barnecle/EmbeddedSystems/lab9/screenShots/Screen Shot 2022-04-12 at 2.54.14 AM.png

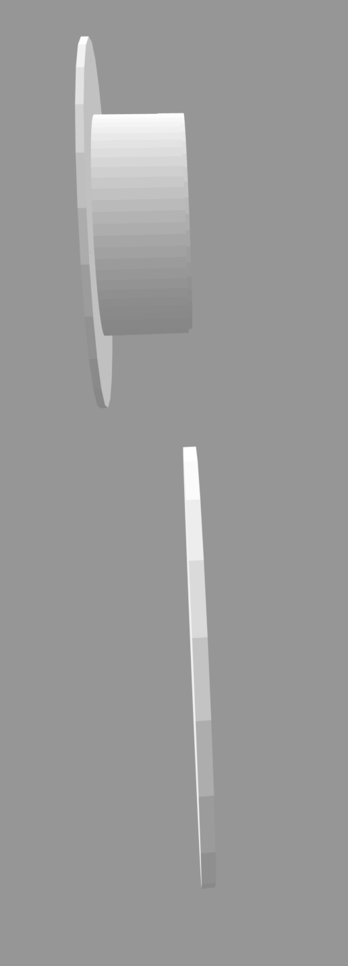
lab9/screenShots/Screen Shot 2022-04-12 at 2.54.14 AM.png
