barnecle/EmbeddedSystems/BOM.xlsx

Reference Designators | Component Manufacturer's Part number | Component Description | Distributor | Unit Cost | # of Units | Extended Cost | Link to component
U1 | STM32L432KCU6 | STM32L432KCUx | Digikey | 7.53 | 1 | 7.53 | https://www.digikey.com/en/products/detail/stmicroelectronics/STM32L432KCU6/6132749
C6. C4 | C0603C104K3RAC7013 | 0.1uF | Digikey | 0.14 | 2 | 0.28 | https://www.digikey.com/en/products/detail/kemet/C0603C104K3RAC7013/8572407
C2, C1 | 298D105X0016M2T | 1uF | Digikey | 1.09 | 2 | 2.18 | https://www.digikey.com/en/products/detail/vishay-sprague/298D105X0016M2T/1559509
TP1 |  | TestPoint |  |  |  | 0
U3 | TG-3541CE 32.7680KXB3 | 32.768 kHz TCXO CMOS Oscillator 1.5V ~ 5.5V Enable/Disable 10-SMD, No Lead | Digikey | 3.6 | 1 | 3.6 | https://www.digikey.com/en/products/detail/epson/TG-3541CE-32-7680KXB3/10239841
TP2 |  | TestPoint |  |  |  | 0
J1 | B3B-XH-A(LF)(SN) | CONN HEADER VERT 3POS 2.5MM | Digikey | 0.19 | 1 | 0.19 | https://www.digikey.com/en/products/detail/jst-sales-america-inc/B3B-XH-A-LF-SN/1651046
JP2 |  | Jumper_3_Open |  |  |  | 0
BT1 | 1060TR | Battery_Cell | Digikey | 1.54 | 1 | 1.54 | https://www.digikey.com/en/products/detail/keystone-electronics/1060TR/303557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
IC1 | TSL237S-LF | Optical Sensor Ambient 635nm Frequency Radial - 3 Leads | Digikey | 1.865 | 10000 | 18650
TP6 |  | TestPoint |  |  |  | 0
J3 | B4B-XH-A(LF)(SN) | CONN HEADER VERT 4POS 2.5MM | Digikey | 0.21 | 1 | 0.21
R3, R4 | ERJ-PA3F2000V | 200 R | Digikey | 0.16 | 2 | 0.32 | https://www.digikey.com/en/products/detail/panasonic-electronic-components/ERJ-PA3F2000V/5035883
U2 | FTSH-107-01-L-DV-K | CONN HEADER SMD 14POS 1.27MM | Digikey | 5.72 | 1 | 5.72 | https://www.digikey.com/en/products/detail/samtec-inc/FTSH-107-01-L-DV-K/6678186
