barnecle/EmbeddedSystems/Light_Sensor_schematic/OSH_PARK_ORDER.png

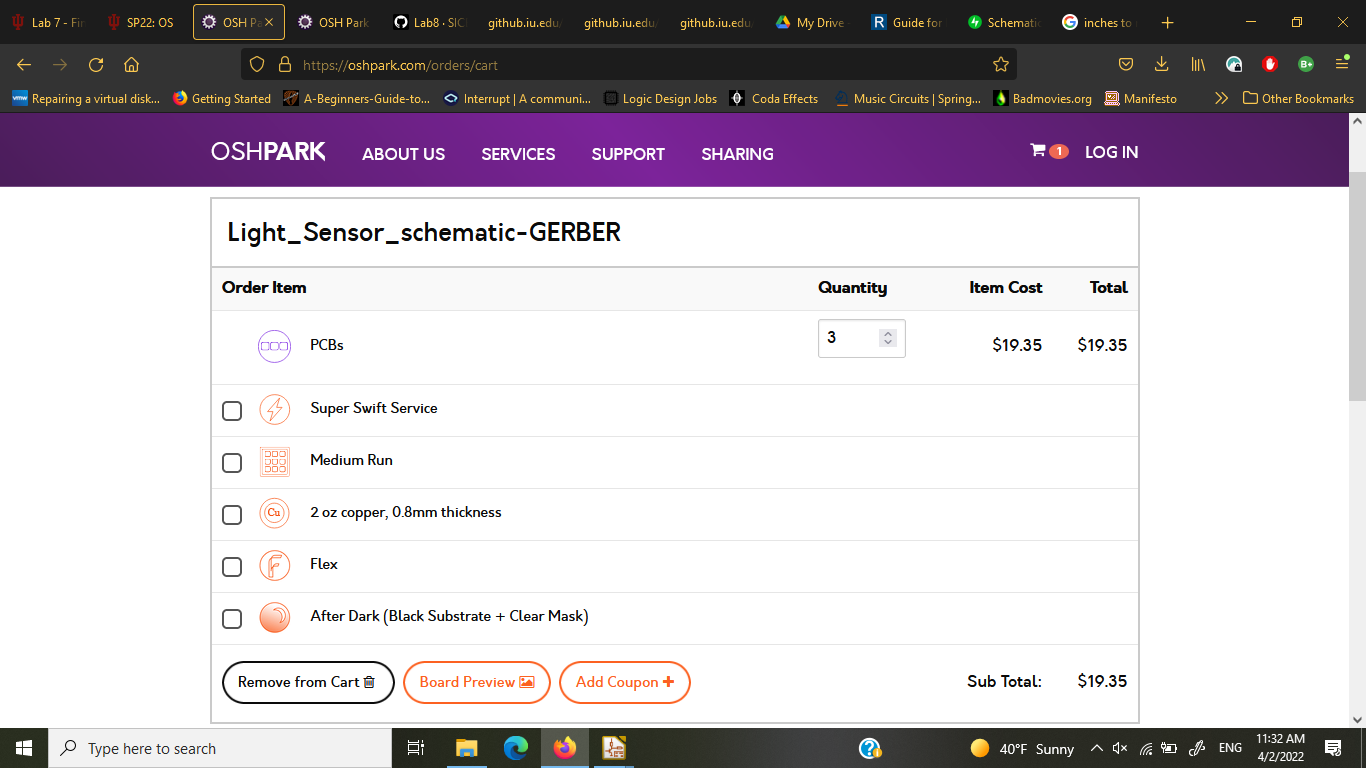
Light_Sensor_schematic/OSH_PARK_ORDER.png
