barnecle/EmbeddedSystems/kicad/parts/3D_Models/03__3DMODEL__TG-3541CE_REV0_ASM_sp.step

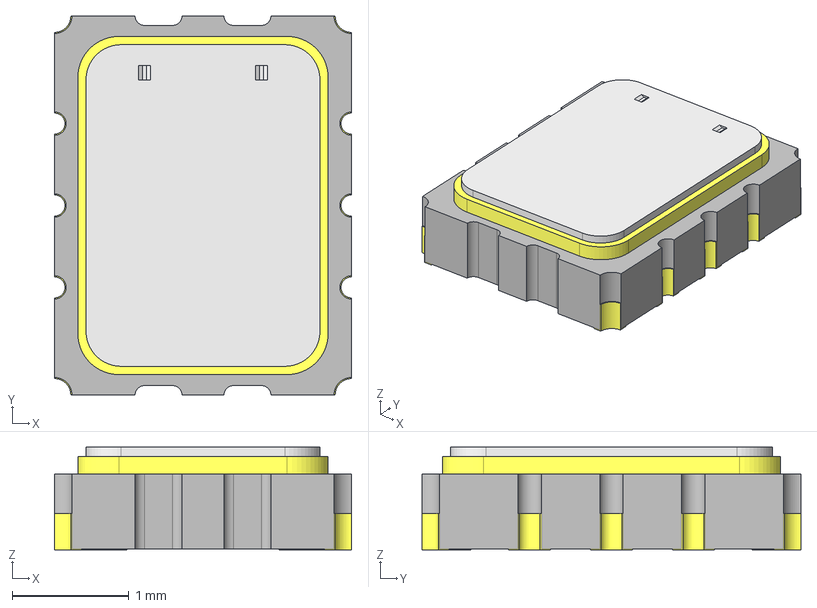
[picture p10: CAD file, 2022-03-24]
kicad/parts/3D_Models/03__3DMODEL__TG-3541CE_REV0_ASM_sp.step
2.54 x 3.24 x 0.88 mm
