barnecle/EmbeddedSystems/kicad/parts/3D_Models/Fusion_sp.step

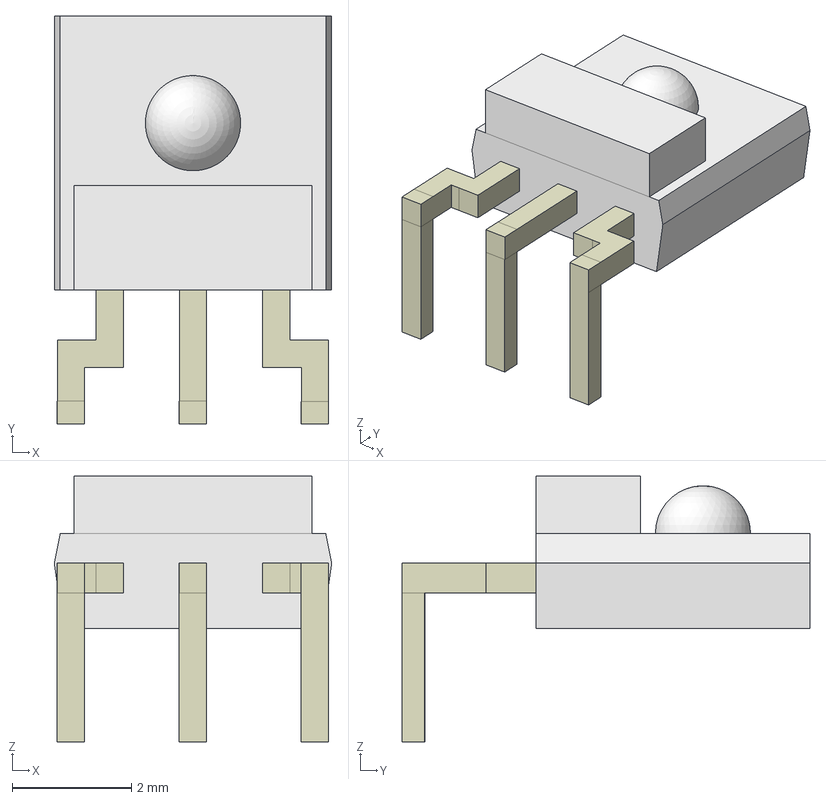
[picture p11: CAD file, 2022-03-24]
kicad/parts/3D_Models/Fusion_sp.step
4.66 x 6.85 x 4.46 mm
