barnecle/EmbeddedSystems/lab9/bottom_part.stl

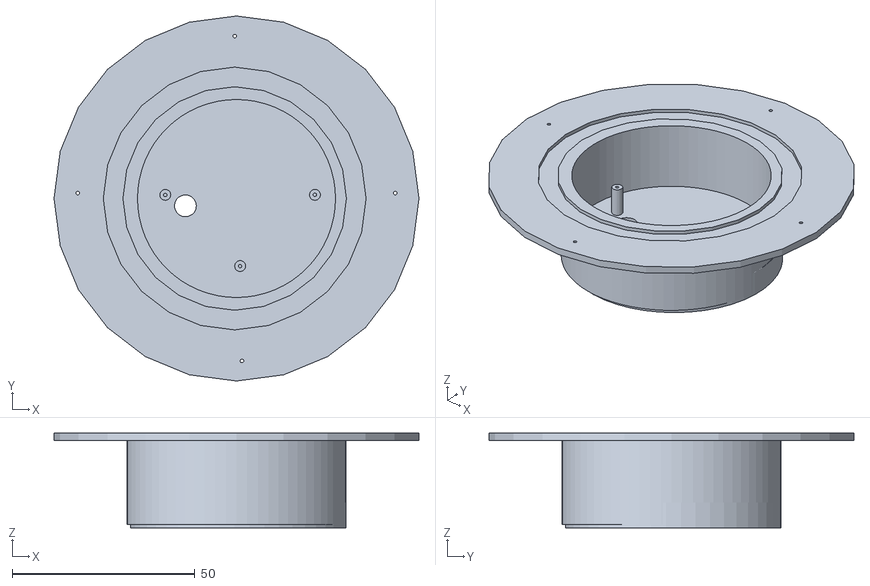
[picture p12: CAD file, 2022-04-20]
lab9/bottom_part.stl
100.0 x 100.0 x 26.0
