barnecle/EmbeddedSystems/kicad/parts/3D_Models/TSL237.FCStd

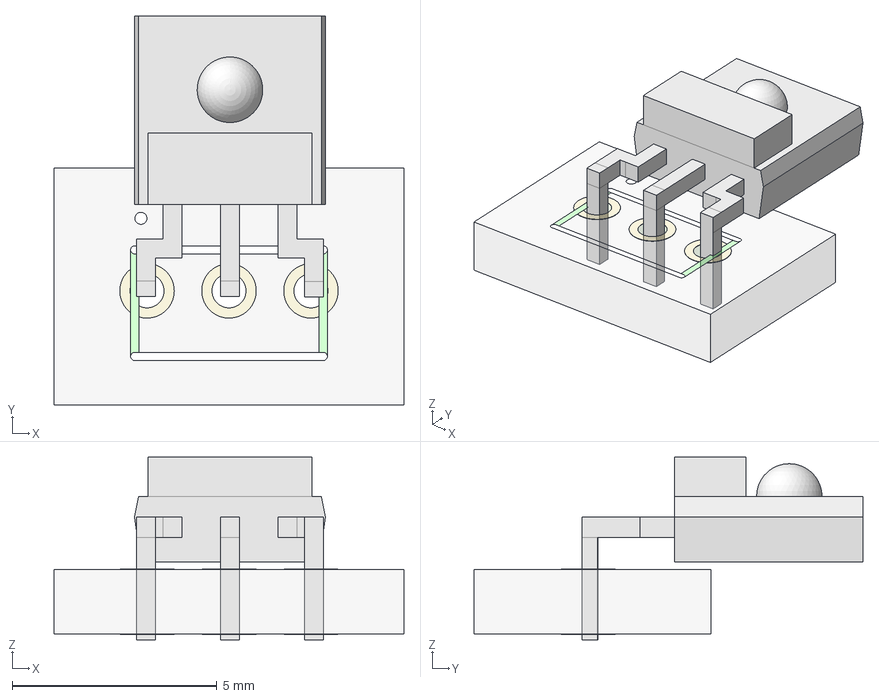
[picture p13: CAD file, 2022-03-24]
kicad/parts/3D_Models/TSL237.FCStd
8.53 x 9.49 x 4.46 mm
FFab
FrontSilk
TopPads
BotPads
PTHs
Pcb
Fusion_sp
