barnecle/EmbeddedSystems/lab9/enclosure.stl

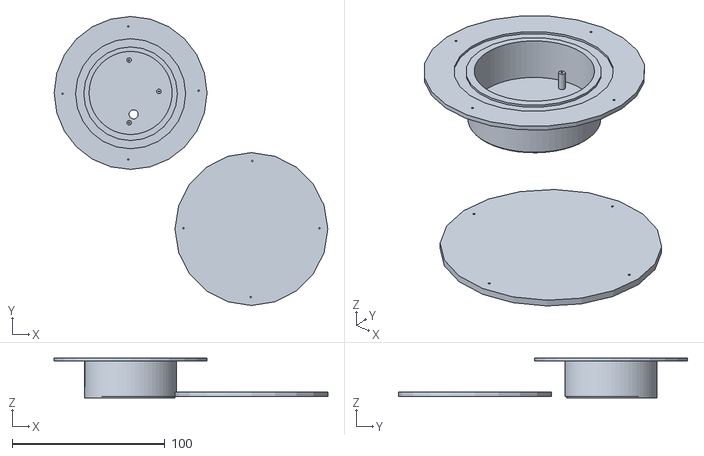
[picture p14: CAD file, 2022-04-12]
lab9/enclosure.stl
179.0 x 189.0 x 26.0
