barnecle/EmbeddedSystems/kicad/parts/3D_Models/TLH-5935.FCStd

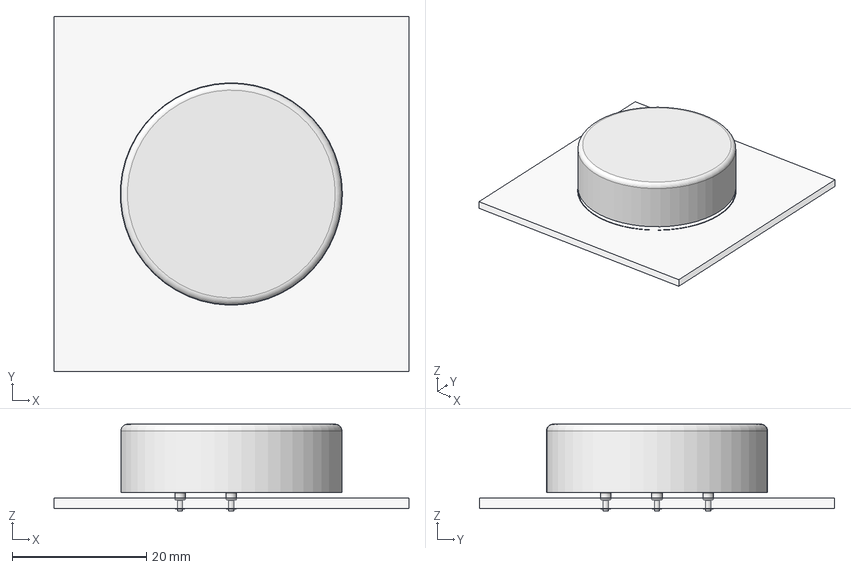
[picture p15: CAD file, 2022-03-24]
kicad/parts/3D_Models/TLH-5935.FCStd
52.8 x 52.8 x 12.9 mm
FrontSilk
TopPads
BotPads
PTHs
Pcb
Body_sp
