barnecle/EmbeddedSystems/kicad/parts/3D_Models/TG-3541CE.FCStd

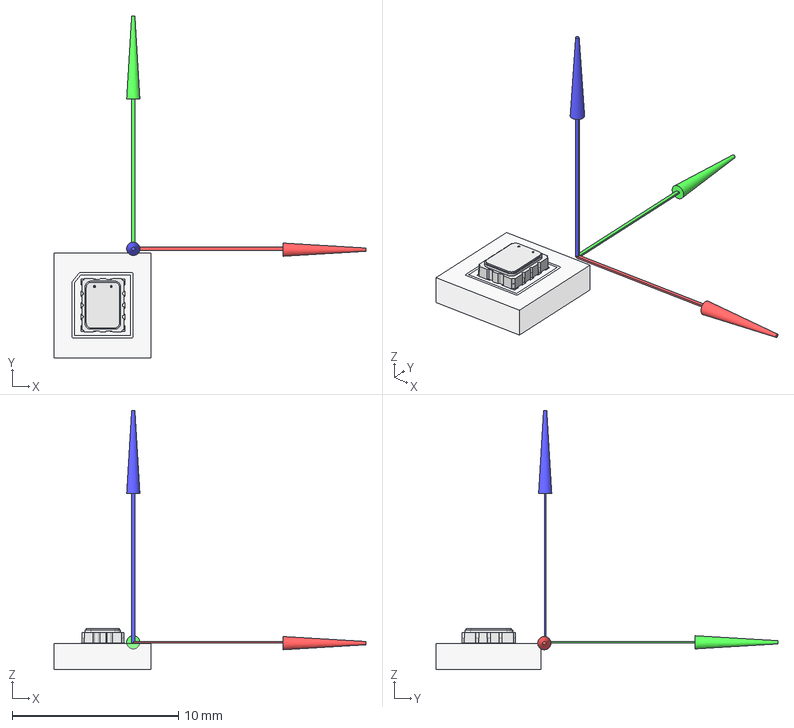
[picture p16: CAD file, 2022-03-24]
kicad/parts/3D_Models/TG-3541CE.FCStd
18.8 x 20.6 x 15.6 mm
FrontSilk
TopPads
Pcb
Z
Y
X
03__3DMODEL__TG-3541CE_REV0_ASM_sp
