barnecle/EmbeddedSystems/kicad/parts/3D_Models/Body_sp.step

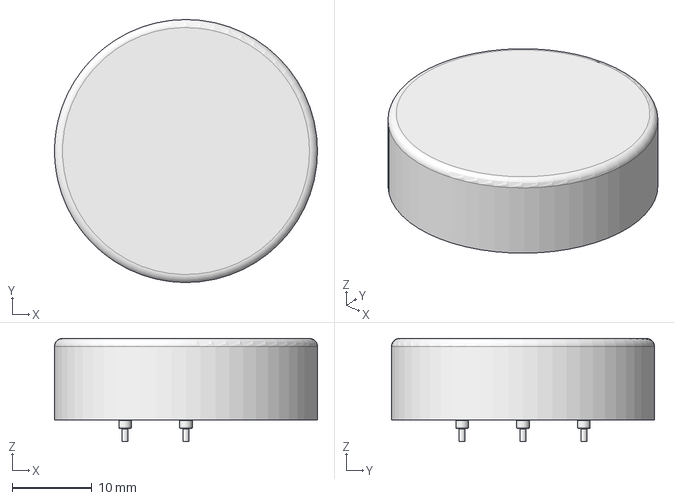
[picture p17: CAD file, 2022-03-24]
kicad/parts/3D_Models/Body_sp.step
32.9 x 32.9 x 12.9 mm
