barnecle/EmbeddedSystems/lab7/Schematic.pdf

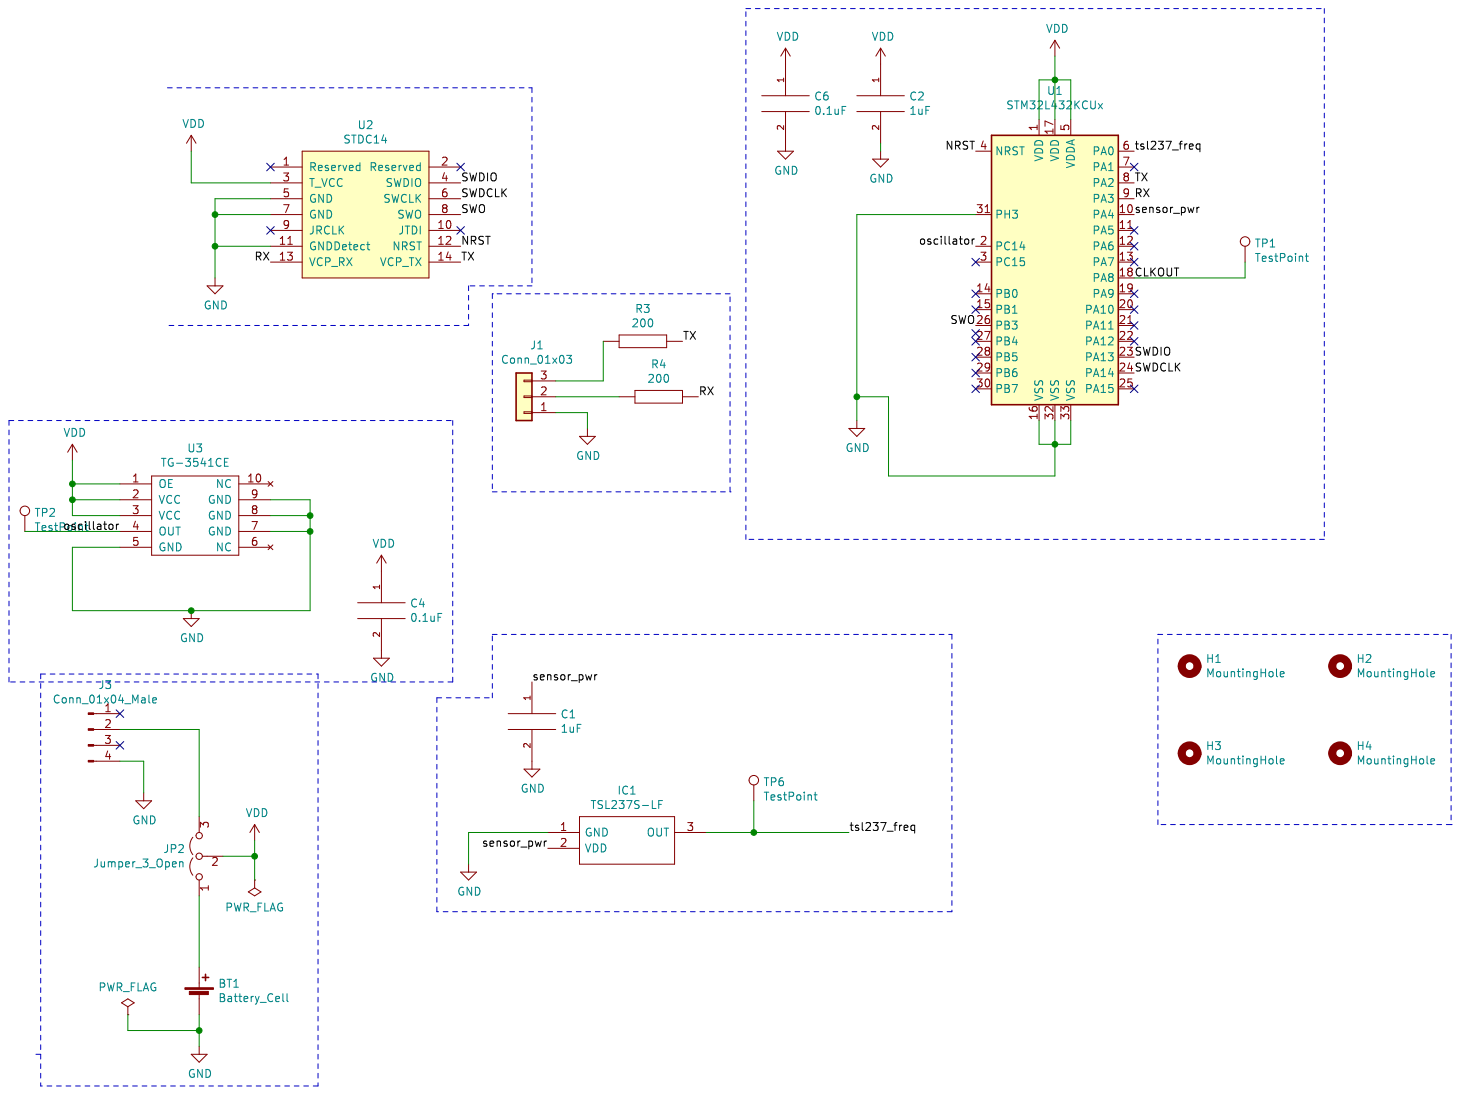
[picture p18: page 1]
