barnecle/EmbeddedSystems/Light_Sensor_schematic/Light_Sensor_schematic.kicad_pcb

## KiCad design Light_Sensor_schematic/Light_Sensor_schematic.kicad_pcb (2022-04-20)

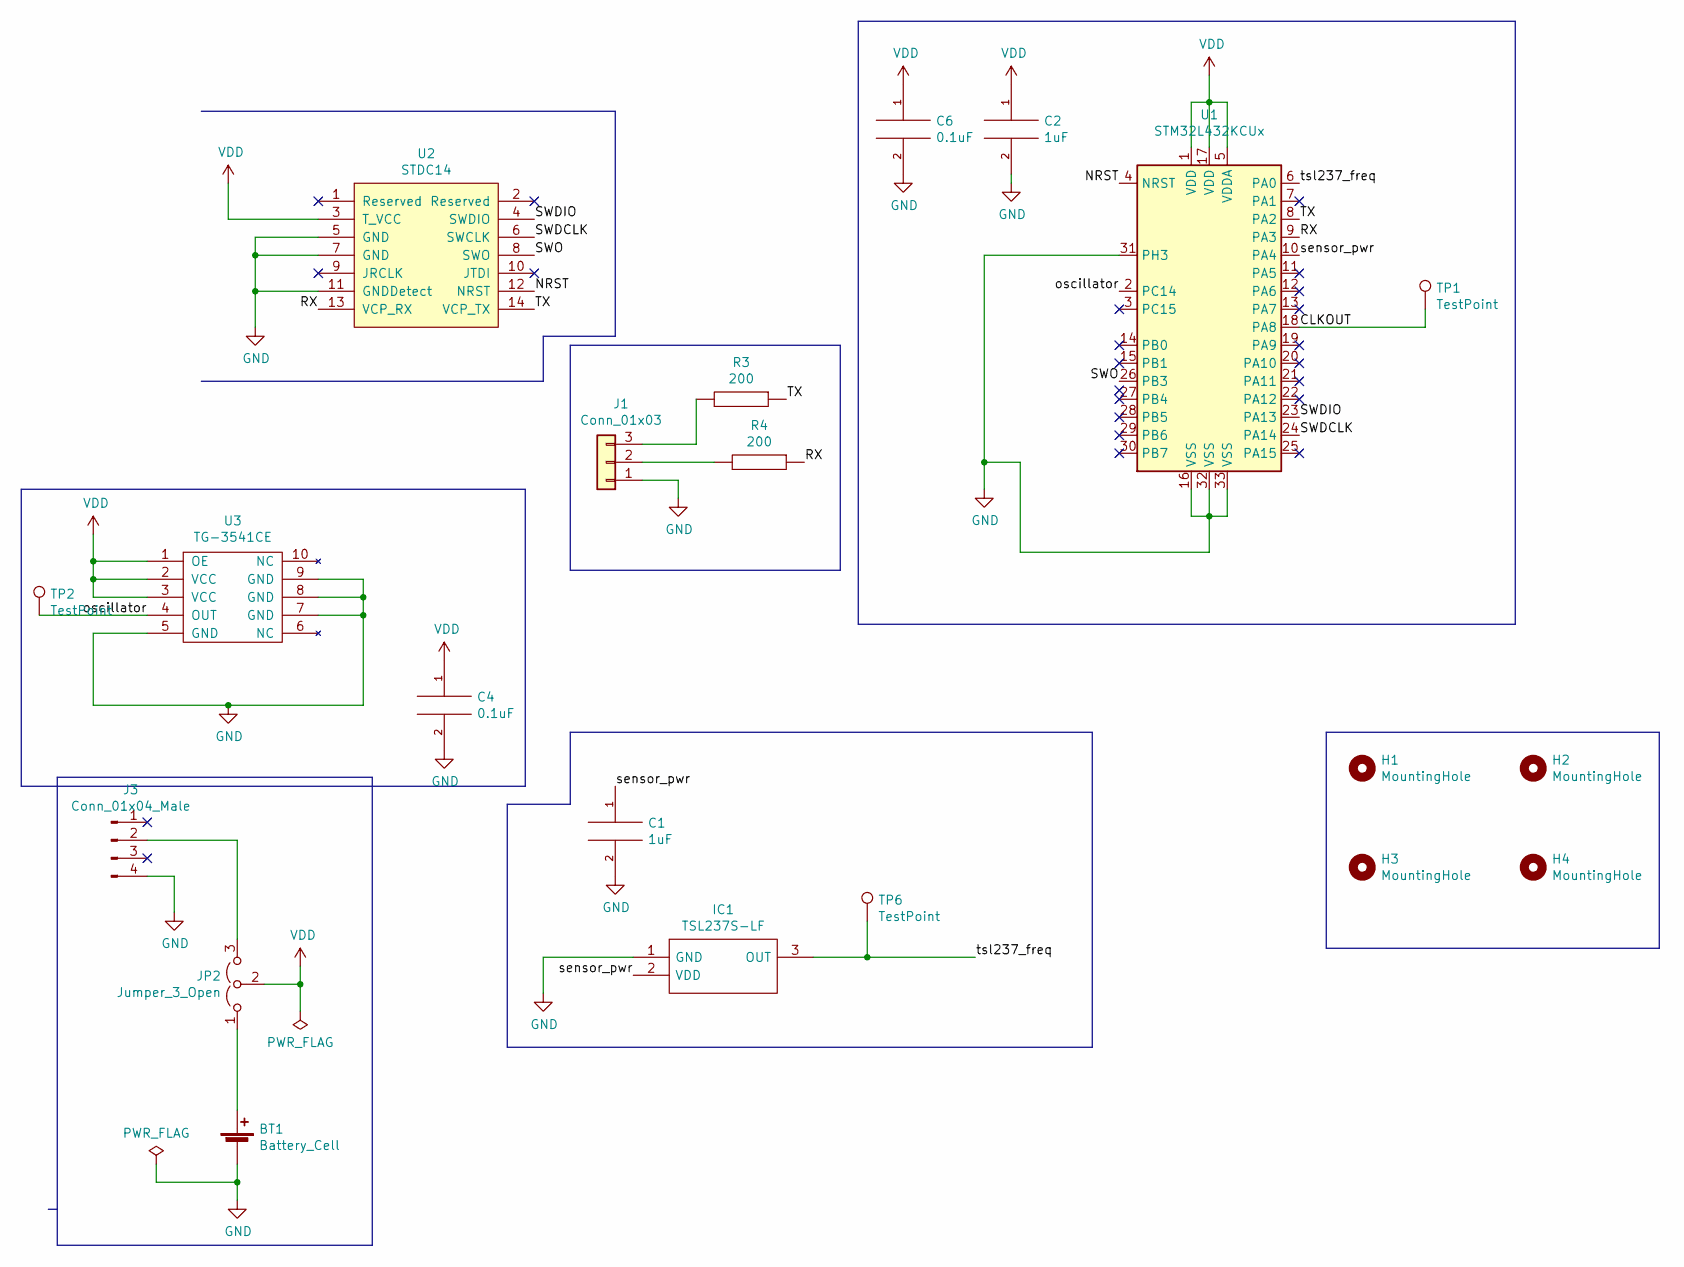
[picture p19: schematic Light_Sensor_schematic.kicad_sch]

Parts:
BT1: Battery_Cell; BatteryHolder_Keystone_1060_1x2032
C1, C2: 1uF; C_0603_1608Metric_Pad1.08x0.95mm_HandSolder
C4, C6: 0.1uF; C_0603_1608Metric_Pad1.08x0.95mm_HandSolder
H1, H2, H3, H4: MountingHole; MountingHole_2.2mm_M2_Pad_Via
IC1: TSL237S-LF; Mouser Part Number 856-TSL237S-LF
J1: Conn_01x03; JST_XH_B3B-XH-AM_1x03_P2.50mm_Vertical
J3: Conn_01x04_Male; JST_XH_B4B-XH-AM_1x04_P2.50mm_Vertical
JP2: Jumper_3_Open; SolderJumper-3_P1.3mm_Open_RoundedPad1.0x1.5mm
R3, R4: 200; R_0603_1608Metric_Pad0.98x0.95mm_HandSolder
TP1, TP2, TP6: TestPoint; TestPoint_Pad_D1.5mm
U1: STM32L432KCUx; QFN-32-1EP_5x5mm_P0.5mm_EP3.45x3.45mm
U2: STDC14; ftsh_14p_connector
U3: TG-3541CE

Connections:
/CLKOUT: TP1.1, U1.18 (PA8)
/NRST: U1.4 (NRST), U2.12 (NRST)
/RX: R4.1, U1.9 (PA3), U2.13 (VCP_RX)
/SWDCLK: U1.24 (PA14), U2.6 (SWCLK)
/SWDIO: U1.23 (PA13), U2.4 (SWDIO)
/SWO: U1.26 (PB3), U2.8 (SWO)
/TX: R3.1, U1.8 (PA2), U2.14 (VCP_TX)
/oscillator: TP2.1, U1.2 (PC14), U3.4 (OUT)
/sensor_pwr: C1.1, IC1.2 (VDD), U1.10 (PA4)
/tsl237_freq: IC1.3 (OUT), TP6.1, U1.6 (PA0)
GND: BT1.2 (-), C1.2, C2.2, C4.2, C6.2, IC1.1 (GND), J1.1, J3.4, U1.16 (VSS), U1.31 (PH3), U1.32 (VSS), U1.33 (VSS), U2.5 (GND), U2.7 (GND), U2.11 (GNDDetect), U3.5 (GND), U3.7 (GND), U3.8 (GND), U3.9 (GND)
unnamed: BT1.1 (+), JP2.1 (A)
unnamed: J1.2, R4.2
unnamed: J1.3, R3.2
unnamed: J3.2, JP2.3 (B)
VDD: C2.1, C4.1, C6.1, JP2.2 (C), U1.1 (VDD), U1.5 (VDDA), U1.17 (VDD), U2.3 (T_VCC), U3.1 (OE), U3.2 (VCC), U3.3 (VCC)

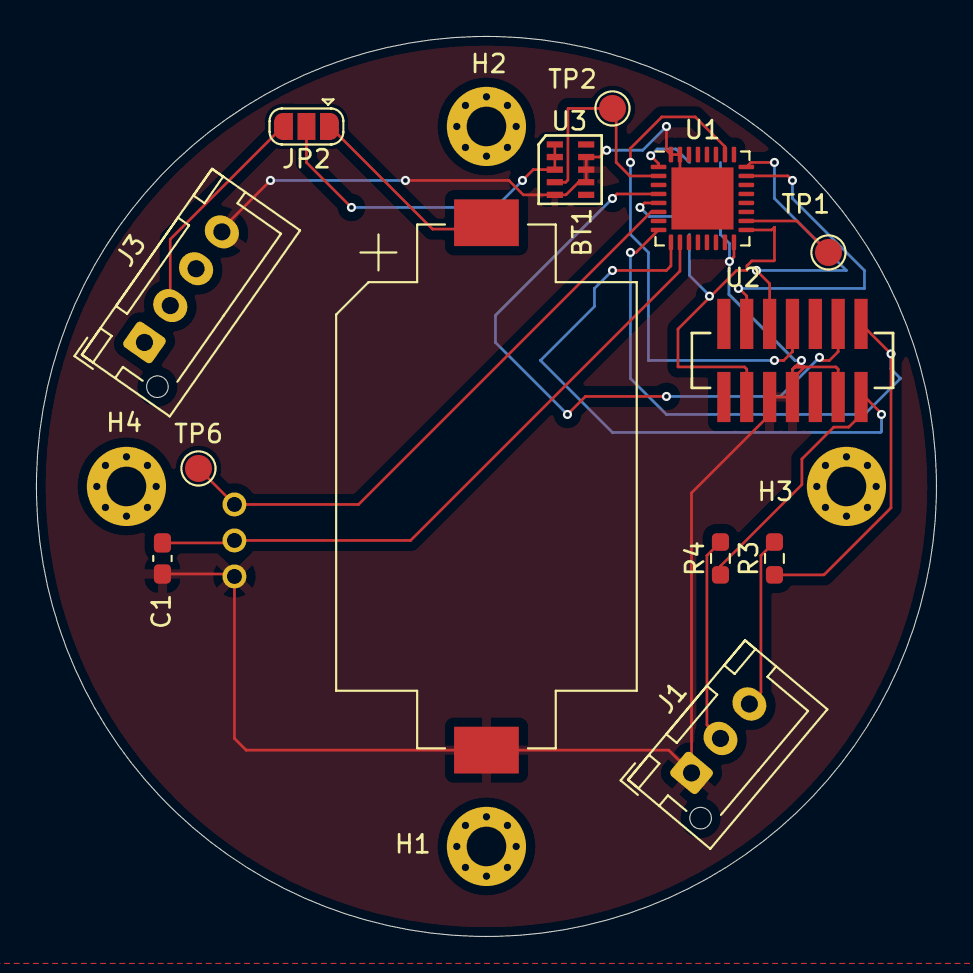
[picture p20: board Light_Sensor_schematic.kicad_pcb from above]

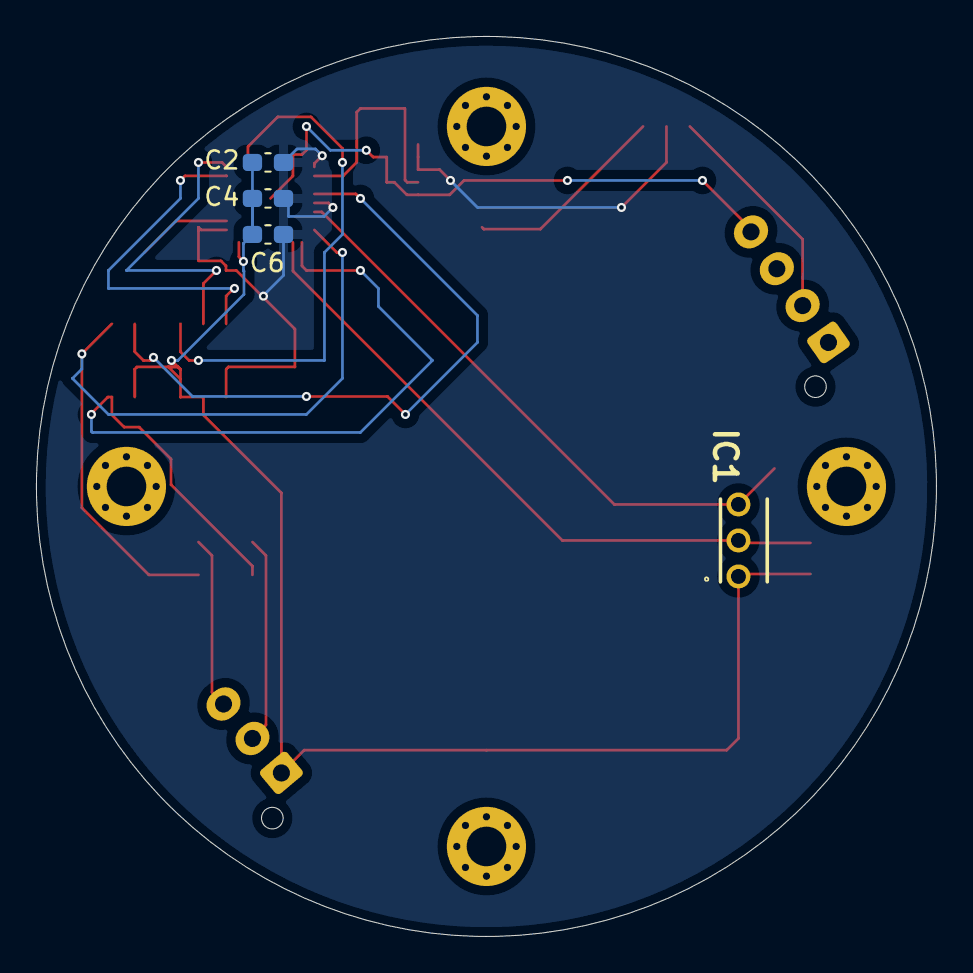
[picture p21: board Light_Sensor_schematic.kicad_pcb from below]

Board: 2 copper layers, 50.0 x 50.0 mm, 21 parts (4 on the bottom side), 16 nets.
