barnecle/EmbeddedSystems/lab6/Core/Src/main.c

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
/* Includes ------------------------------------------------------------------*/
#include "main.h"

/* USER CODE BEGIN Includes */
#include <stdlib.h>
#include <stdio.h>
#include "stm32l4xx_ll_usart.h"
#include <string.h>
#include <retarget.h>
#include <command.h>
#include "queue.h"
#include "temp.h"
#include "battery.h"
#include "flash.h"
/* USER CODE END Includes */

/* USER CODE BEGIN PD */
typedef struct command {
  char * cmd_string;
  int (*cmd_function)(char * arg);
} command_t;
/* USER CODE END PD */

ADC_HandleTypeDef hadc1;

RTC_HandleTypeDef hrtc;

TIM_HandleTypeDef htim2;

UART_HandleTypeDef huart2;

/* USER CODE BEGIN PV */
queue_t rx_queue;
int led_on = 0;
volatile int toggle = 0;
volatile uint32_t period = 0;
volatile uint32_t timer_done = 0;
flash_status_t flash_status;

/* USER CODE END PV */

void SystemClock_Config(void);
static void MX_GPIO_Init(void);
static void MX_USART2_UART_Init(void);
static void MX_RTC_Init(void);
static void MX_ADC1_Init(void);
static void MX_TIM2_Init(void);
/* USER CODE BEGIN PFP */
int help_command(char *args);
int lof_command();
int lon_command();
int test_command(char *args);
int dateSet_command(char *args);
int timeSet_command(char *args);
void printDateTime();
int parse_command (uint8_t *line, uint8_t **command, uint8_t **args);
int execute_command(uint8_t * line);
int tsl237_command(char *arguments);
int temp_command(char *arguments);
int battery_command(char *arguments);
//void log_mem(char *m);
/* USER CODE END PFP */

/* USER CODE BEGIN 0 */
command_t commands[] = {
  {"help",help_command},
  {"lof",lof_command},
  {"lon",lon_command},
  {"test",test_command},
  {"ds",dateSet_command},
  {"ts",timeSet_command},
  {"tsl237",tsl237_command},
  {"temp",temp_command},
  {"battery",battery_command},
  {"sample", sample_command},
  {"data", data_command},
  {"ef", ef_command},
  {"log", log_command},
  {"l", l_command},
  {0,0}
};

void HAL_TIM_IC_CaptureCallback(TIM_HandleTypeDef *htim) {
  enum {EDGE1,EDGE2};
  static uint32_t last = 0;
  static uint32_t state = EDGE1;
  uint32_t next;
  if(htim->Channel == HAL_TIM_ACTIVE_CHANNEL_1){
	  next = htim->Instance->CCR1;
	  switch(state){
	  case EDGE1:
		  last = next;
		  state = EDGE2;
		  break;
	  case EDGE2:
		  if(next>last){
			  period = next-last;
		  }
		  else{
			  period = htim->Instance->ARR - last + next;
		  }
		  state = EDGE1;
		  HAL_TIM_IC_Stop_IT(&htim2,TIM_CHANNEL_1);
		  timer_done = 1;
		  break;
	  default:
		  state = EDGE1;
		  break;
	  }
  }
}
/* USER CODE END 0 */

/**
  * @brief  The application entry point.
  * @retval int
  */
int main(void)
{
  /* MCU Configuration--------------------------------------------------------*/

  /* Reset of all peripherals, Initializes the Flash interface and the Systick. */
  HAL_Init();

  /* USER CODE BEGIN Init */
  uint8_t command_line[QUEUE_SIZE];
  uint8_t ch;
  //RTC_DateTypeDef date;
  //RTC_TimeTypeDef time;
  int n = 0;
  /* USER CODE END Init */

  /* Configure the system clock */
  SystemClock_Config();

  /* Initialize all configured peripherals */
  MX_GPIO_Init();
  MX_USART2_UART_Init();
  MX_RTC_Init();
  MX_ADC1_Init();
  MX_TIM2_Init();
  /* USER CODE BEGIN 2 */
  HAL_ADC_Init(&hadc1); // Initialize the A2D
  while (HAL_ADCEx_Calibration_Start(&hadc1,ADC_SINGLE_ENDED) != HAL_OK);   // Calibrate the A2D
  RetargetInit(&huart2);
  LL_USART_EnableIT_RXNE(USART2);
  printf("\r\nSystem Running\n\r");
  printf("\r\n IULS>");
  //date.WeekDay = 1;
  //date.Month = 1;
  //date.Date = 1;
 // date.Year = 1;
  //time.Hours = 1;
  //time.Minutes = 1;
  //HAL_RTC_SetDate(&hrtc,&date,RTC_FORMAT_BIN);
  //HAL_RTC_SetTime(&hrtc,&time,RTC_FORMAT_BIN);
  /* USER CODE END 2 */

  /* Infinite loop */
  /* USER CODE BEGIN WHILE */
  flash_write_init(&flash_status);
  while (1)
  {
	if(toggle){
		HAL_GPIO_TogglePin(LD3_GPIO_Port, LD3_Pin);
		HAL_Delay(100);
		HAL_GPIO_TogglePin(LD3_GPIO_Port, LD3_Pin);
		toggle = 0;
	}
    if ((ch = dequeue(&rx_queue))) {
      putchar(ch);
      command_line[n] = ch;
      if(ch == '\r' || ch == '\n'){
    	  command_line[n] = '\0'; //end of string
    	  if(!execute_command(command_line)){
    		  printf("\r\nOK");
    	  }else{
    		  printf("\r\nNOK");
    	  }
    	  n = 0;
    	  printf("\r\n");
    	  printDateTime();
    	  printf(" IULS>");
      }else{
    	  n++;
      }

    }
  }


    /* USER CODE END WHILE */

}

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
/* USER CODE BEGIN 4 */
int execute_command(uint8_t * line) {
  uint8_t *cmd;
  uint8_t *arg;
  command_t *p = commands;
  int success = 1;

  if (!line) {
    return (-1); // Passed a bad pointer
  }
  if (parse_command(line,&cmd,&arg) == -1) {
    printf("Error with parse command\n\r");
    return (-1);
  }
  while (p->cmd_string) {
    if (!strcmp(p->cmd_string,(char *) cmd)) {
      if (!p->cmd_function) {
        return (-1);
      }
      success = (*p->cmd_function)((char *)arg);            // Run the command with the passed arguments
      //success = 1;
      break;
    }
    p++;
  }
  if (success == 0) {
    return (0);
  }
  else {
    return (-1);
  }
  }
int parse_command (uint8_t *line, uint8_t **command, uint8_t **args){

  uint8_t *line_temp;
  if((!line) || (!command) || (!args)){ //check for bad pointer
    return(-1);
  }
  line_temp= line;
  *command = line;
  //strcpy(line_left, line);
  while(*line_temp != ','){ //increment through input to find end of command
    if(!*line_temp){
      *args = '\0'; //no arguments
      return(0);
    }
    line_temp++;
  }

  *line_temp = '\0'; //replace comma with null for end of command string
  *args = line_temp +1; //one char past null is beginning of arguments
  return 0;
}
int help_command(char *args){
  printf("\r\nAvailable Commands:\n\r");
  printf("lon\n\r");
  printf("lof\n\r");
  printf("test\n\r");
  printf("ds\n\r");
  printf("ts\n\r");
  return 0;
}
int lon_command(){
  if(led_on == 0){
    HAL_GPIO_TogglePin(LD3_GPIO_Port, LD3_Pin);
    led_on = 1;
    printf("\r\nLED ON\n\r");
  }else{
    printf("\r\nLED ALREADY ON\n\r");
  }
  return 0;
}
int lof_command(){
  if(led_on == 1){
    HAL_GPIO_TogglePin(LD3_GPIO_Port, LD3_Pin);
    led_on = 0;
    printf("\r\nLED OFF\n\r");
  }else{
    printf("\r\nLED ALREADY OFF\n\r");
  }
  return 0;
}
int test_command(char *args){
  printf("\r\ntest\n\r");
  while(*args!='\0'){
    if(*args!=','){
      putchar(*args);
    }else{
      printf("\r\n");
    }
    args++;
  }
  return 0;
}
void printDateTime(){
	RTC_DateTypeDef date;
	RTC_TimeTypeDef time;
	HAL_RTC_GetTime(&hrtc,&time,RTC_FORMAT_BIN);
	HAL_RTC_GetDate(&hrtc,&date,RTC_FORMAT_BIN);
	printf("%2.2u/%2.2u/%4.4u %2.2u:%2.2u:%2.2u",date.Month,date.Date,date.Year+2000,time.Hours,time.Minutes,time.Seconds);
}
int dateSet_command(char *args){
	RTC_DateTypeDef date;
	//HAL_StatusTypeDef hal;
	int comma_count = 0;
	char* start_of_num = args;
	int numbers[3];
	while(*args!='\0'){
	    if(*args==','){
	    	*args = '\0';
	        numbers[comma_count] = atoi(start_of_num);
	        comma_count += 1;
	        start_of_num = args+1;
	    }
	    if(comma_count>2){
	    	//printf("\r\n error \n\r");
	    	return 1;
	    }
	    args++;
	  }
	numbers[comma_count] = atoi(start_of_num);
	if(numbers[0]>12 || numbers[0] < 1 || numbers[1] > 31 || numbers[1]<1 || numbers[2] > 100 || numbers[2]<0)
		return 1;
	date.WeekDay = 1;
	date.Month = numbers[0];
	date.Date = numbers[1];
	date.Year = numbers[2];
	HAL_RTC_SetDate(&hrtc,&date,RTC_FORMAT_BIN);
	return 0;
	//hal = HAL_RTC_SetDate(&hrtc,&date,RTC_FORMAT_BIN);
	//printf("\r\n%x\r\n",hal);
}
int timeSet_command(char *args){
	RTC_TimeTypeDef time;
	int comma_count = 0;
	char* start_of_num = args;
	int numbers[3];
	while(*args!='\0'){
		if(*args==','){
			*args = '\0';
		    numbers[comma_count] = atoi(start_of_num);
		    comma_count += 1;
		    start_of_num = args+1;
		}
		if(comma_count>2){
			//printf("\r\n error \n\r");
		    return 1;
		}
		args++;
	}
	if(numbers[0]>24 || numbers[0] < 1 || numbers[1] > 60 || numbers[1]<1 || numbers[2] > 60 || numbers[2]< 1)
		return 1;
	numbers[comma_count] = atoi(start_of_num);
	time.Hours = numbers[0];
	time.Minutes = numbers[1];
	time.Seconds = numbers[2];

	HAL_RTC_SetTime(&hrtc,&time,RTC_FORMAT_BIN);
	return 0;
}
void HAL_RTC_AlarmAEventCallback(RTC_HandleTypeDef *hrtc)
{
	toggle=1;
	//HAL_GPIO_TogglePin(LD3_GPIO_Port, LD3_Pin);
}
int tsl237_command(char *args){
	  //float clock_period;
	  //float sensor_period;
	  float sensor_frequency;

	  if (args) {
	    return 1;
	  }
	  else {
		timer_done = 0;
		HAL_TIM_IC_Start_IT(&htim2,TIM_CHANNEL_1);
		while(!timer_done);


	    //clock_period = SystemCoreClock;
	    //clock_period = 1/clock_period;
	    //sensor_period = clock_period * (float) period;
	    sensor_frequency = (1.0/((float)period/(float)SystemCoreClock));
	    printf("\r\n%d.%d hz\r\n", (int) sensor_frequency, ((int)(sensor_frequency*100)%100));
	    return 0;
	  }
}

int temp_command(char *arguments){
	  if (arguments) {
	    return 1;
	  }
	  else {
	    printf("\r\n%d C\n\r",(int)read_temp());
	    return 0;
	  }

}
int battery_command(char *arguments){
	  uint32_t battery_voltage;
	  if (arguments) {
	    return 1;
	  }
	  else {
	    battery_voltage = read_vrefint();
	    printf("\r\n%d.%03d V\n\r",(int)battery_voltage/1000,(int)battery_voltage%1000);
	    return 0;
	  }
}


/* USER CODE END 4 */
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
