barnecle/EmbeddedSystems/(commit log)

2022-02-04 alternate lab2
    [100ask-openjtag.cfg, 8devices-lima.cfg, actux3.cfg, adapteva_parallella1.cfg, adsp-sc584-ezbrd.cfg, alphascale_asm9260_ek.cfg, altera-10m50.cfg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]
2022-03-26 Lab 7
    [BOM.xlsx]
2022-03-26 Lab 7 schematic
    [Light_Sensor_schematic.kicad_pcb, Light_Sensor_schematic.sch]
2022-03-29 last components added to BOM
    [BOM.xlsx]
2022-04-02 Lab 8
    [Light_Sensor_schematic-B_Cu.gbr, Light_Sensor_schematic-B_Mask.gbr, Light_Sensor_schematic-B_Paste.gbr, Light_Sensor_schematic-B_SilkS.gbr, Light_Sensor_schematic-Edge_Cuts.gbr, Light_Sensor_schematic-F_Cu.gbr, Light_Sensor_schematic-F_Mask.gbr, Light_Sensor_schematic-F_Paste.gbr]
2022-04-12 lab9 done
    [enclosure.stl]
2022-04-20 Kicad5 to 6
    [Light_Sensor_schematic-B_Cu.gbr, Light_Sensor_schematic-B_Mask.gbr, Light_Sensor_schematic-B_Paste.gbr, Light_Sensor_schematic-B_Silkscreen.gbr, Light_Sensor_schematic-Edge_Cuts.gbr, Light_Sensor_schematic-F_Cu.gbr, Light_Sensor_schematic-F_Mask.gbr, Light_Sensor_schematic-F_Paste.gbr]
2022-04-20 add hat part
    [bottom_part.stl]
2022-04-20 corrected DRC errors to allow import at macrofab.
    [Light_Sensor_schematic.kicad_pcb]
