barnecle/EmbeddedSystems/(notices)

Notices in the files:
lab6/Core/Inc/main.h:
Copyright (c) 2022 STMicroelectronics.
All rights reserved.
This software is licensed under terms that can be found in the LICENSE file
embsys_sp22/example/l432_flash/Core/Inc/queue.h:
modify it under the terms of the GNU General Public License as
published by the Free Software Foundation; either version 3, or
(at your option) any later version.
